UBCecohydro/Ecohydro.Arduino/mega-shield/ecohydro-mega-shield-pcb.png

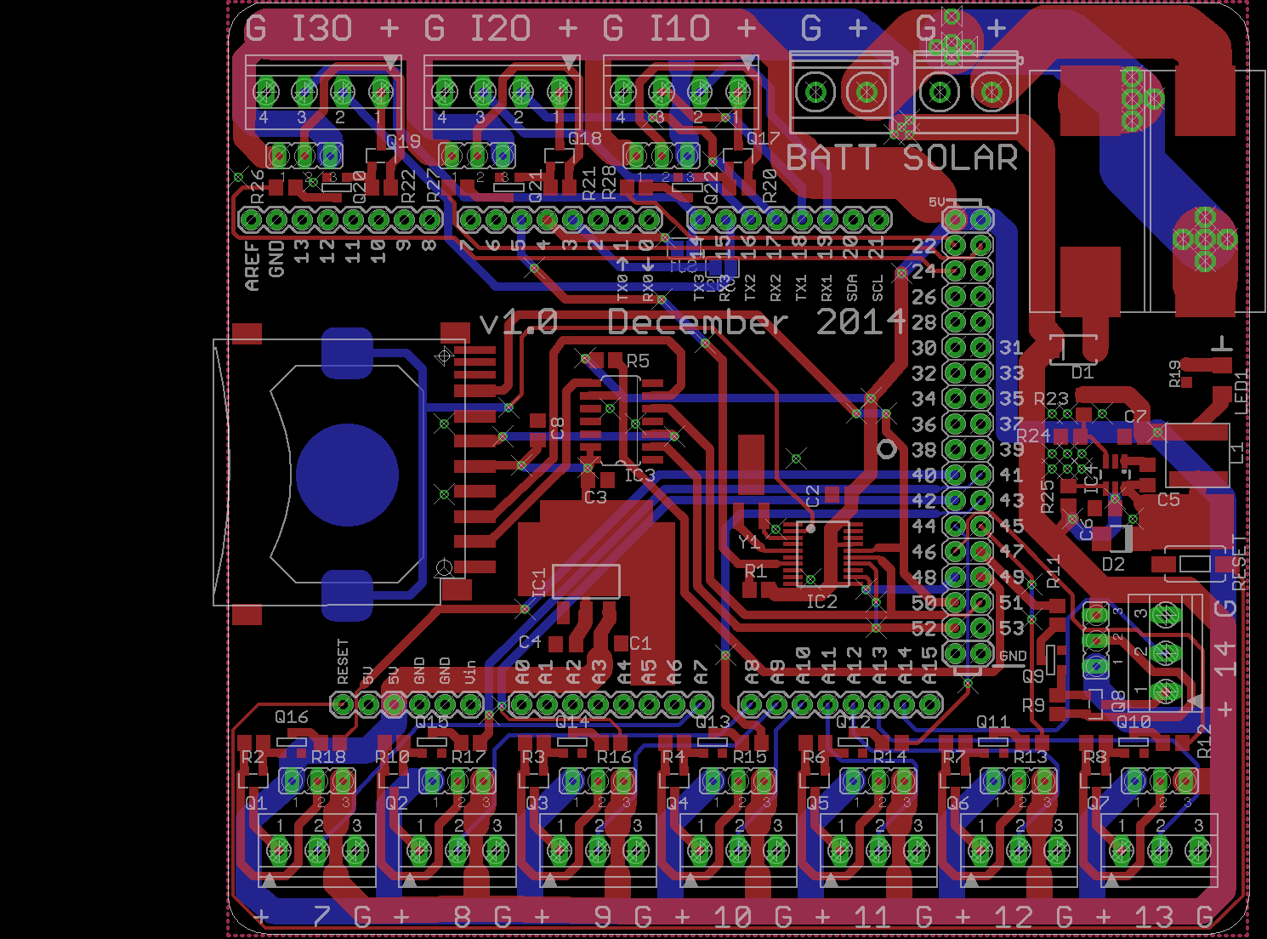
mega-shield/ecohydro-mega-shield-pcb.png
