UBCecohydro/Ecohydro.Arduino/mega-shield/ecohydro-mega-shield-schematic.png

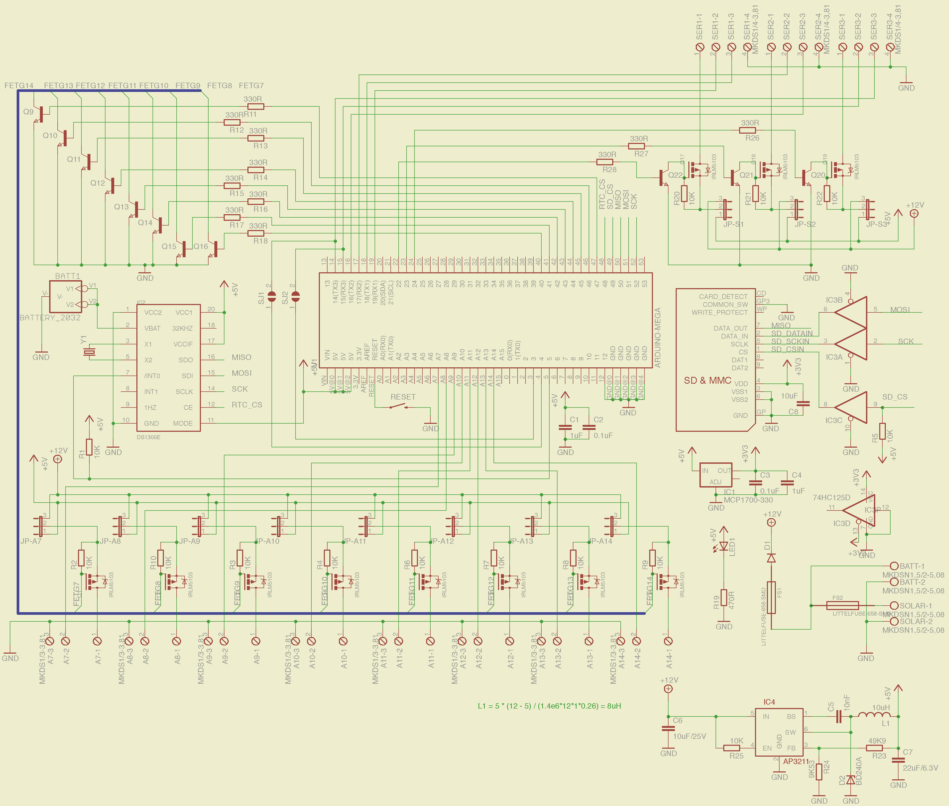
mega-shield/ecohydro-mega-shield-schematic.png
