UBCecohydro/Ecohydro.Arduino/mega-shield/ecohydro-mega-shield.xlsx

Qty | Value | Device | Package | Parts | Description | DIGIKEY | MOUSER | PROD_ID
1 |  | CRYSTAL32-SMD | CRYSTAL-32KHZ-SMD | Y1 | Various standard crystals. Proven footprints. Spark Fun Electronics SKU : COM-00534 | 535-12051-1-ND |  | XTAL-07894
1 |  | DIODESMA | SMA-DIODE | D1 | Diode | S1GFSCT-ND | 625-RS1A-E3/5AT
11 |  | JP2E | JP2 | JP-A7, JP-A8, JP-A9, JP-A10, JP-A11, JP-A12, JP-A13, JP-A14, JP-S1, JP-S2, JP-S3 | JUMPER
1 |  | LED1206 | LED-1206 | LED1 | Light Emitting Diode
2 |  | SJ | SJ | SJ1, SJ2 | SMD solder JUMPER
2 | 0.1uF | C-EUC0805K | C0805K | C2, C3 | CAPACITOR, European symbol
14 | 10K | R-EU_M0805 | M0805 | R1, R2, R3, R4, R5, R6, R7, R8, R9, R10, R20, R21, R22, R25 | RESISTOR, European symbol
1 | 10nF | C-EUC0805K | C0805K | C5 | CAPACITOR, European symbol | 490-1664-1-ND
1 | 10uF | C-EUC0805K | C0805K | C8 | CAPACITOR, European symbol
1 | 10uF/25V | C-EUC0805K | C0805K | C6 | CAPACITOR, European symbol | 1276-2891-1-ND
1 | 10uH | L-USSRN6028N | L6028 | L1 | INDUCTOR, American symbol | 732-5536-1-ND
2 | 1uF | C-EUC0805K | C0805K | C1, C4 | CAPACITOR, European symbol
1 | 22uF/10V | C-EUC0805K | C0805K | C7 | CAPACITOR, European symbol | 1276-1100-1-ND
8 | 330R | R-EU_M0805 | M0805 | R11, R12, R13, R14, R15, R16, R17, R18 | RESISTOR, European symbol | 541-330ACT-ND
3 | 330R | R-EU_M0805 | M0805 | R26, R27, R28 | RESISTOR, European symbol
1 | 4K7 | R-EU_M0805 | M0805 | R19 | RESISTOR, European symbol
1 | 49K9 | R-EU_M0805 | M0805 | R23 | RESISTOR, European symbol | 541-49.9KCCT-ND
1 | 74HC125D | 74HC125D | SO14 | IC3 | Quad bus BUFFER, 3-state | 568-1392-2-ND
1 | 9K53 | R-EU_M0805 | M0805 | R24 | RESISTOR, European symbol | 541-9.53KCCT-ND
1 | AP3211KTR | AP3211KTR | SOT23-6 | IC4 |  | AP3211KTR-G1DICT-ND | 621-AP3211KTR-G1
1 | ARDUINO-MEGA | ARDUINO-MEGA | ARDUINO_MEGA_NOHOLES | U1 | Arduino Mega board footprint
1 | BATTERY_2032 | BATTERY_2032 | BATT2032 | BATT1 | BATTERY | BK-883CT-ND
1 | BD240A | ZENER-DIODE-DO214AC | DO-214AC | D2 | Z-Diode | B240A-E3/61TGICT-ND | 625-B240A-E3/61T
1 | DS1306E | DS1306E | SSOP20 | IC2 | Serial Alarm Real-Time Clock | DS1306EN+T&RCT-ND
11 | IRLM5103 | IRLM5103 | MICRO3 | Q1, Q2, Q3, Q4, Q5, Q6, Q7, Q8, Q17, Q18, Q19 | HEXFET P-Channel Power MOSFET | IRLML5103PBFCT-ND | 942-IRLML5103TRPBF
2 | LITTELFUSE-658-SMD | LITTELFUSE-658-SMD | LITTELFUSE-658-SMD | FS1, FS2 |  | 486-1260-ND | 576-65800001109
1 | MCP1700-330 | V_REG_LM1117SOT223 | SOT223 | IC1 | Voltage Regulator LM1117 | AP1117IE33G-13DITR-ND
8 | MKDS1/3-3,81 | MKDS1/3-3,81 | 3POL381 | A7, A8, A9, A10, A11, A12, A13, A14 | MKDS 1/3-3,81 - Order No. 1727023 (RS-Online - 101-5390)
3 | MKDS1/4-3,81 | MKDS1/4-3,81 | 4POL381 | SER1, SER2, SER3 | MKDS 1/4-3,81 - Order No. 1727036
2 | MKDSN1,5/2-5,08 | MKDSN1,5/2-5,08 | MKDSN1,5/2-5,08 | BATT, SOLAR | MKDSN 1,5/ 2-5,08 Printklemme
11 | PBSS4021NT,215 | PBSS4021NT,215 | SOT-23 | Q9, Q10, Q11, Q12, Q13, Q14, Q15, Q16, Q20, Q21, Q22 |  | PBSS4021NT,215
1 | SDMMC06132 | SDMMC06132 | 6132 | U$1 | SD MMC Card holder
1 | SWITCH-MOMENTARY-2-SMD-1101NE | SWITCH-MOMENTARY-2-SMD-1101NE | TACTILE-SWITCH-1101NE | RESET | Various NO switches- pushbuttons, reed, etc
 |  |  |  |  | 1A Fuse | 507-1261-ND
 |  |  |  |  | 4A Fuse | 507-1268-ND
