UBCecohydro/Ecohydro.Arduino/mega-shield/ecohydro-mega-shield.brd

## EAGLE design mega-shield/ecohydro-mega-shield.brd (2016-04-15)

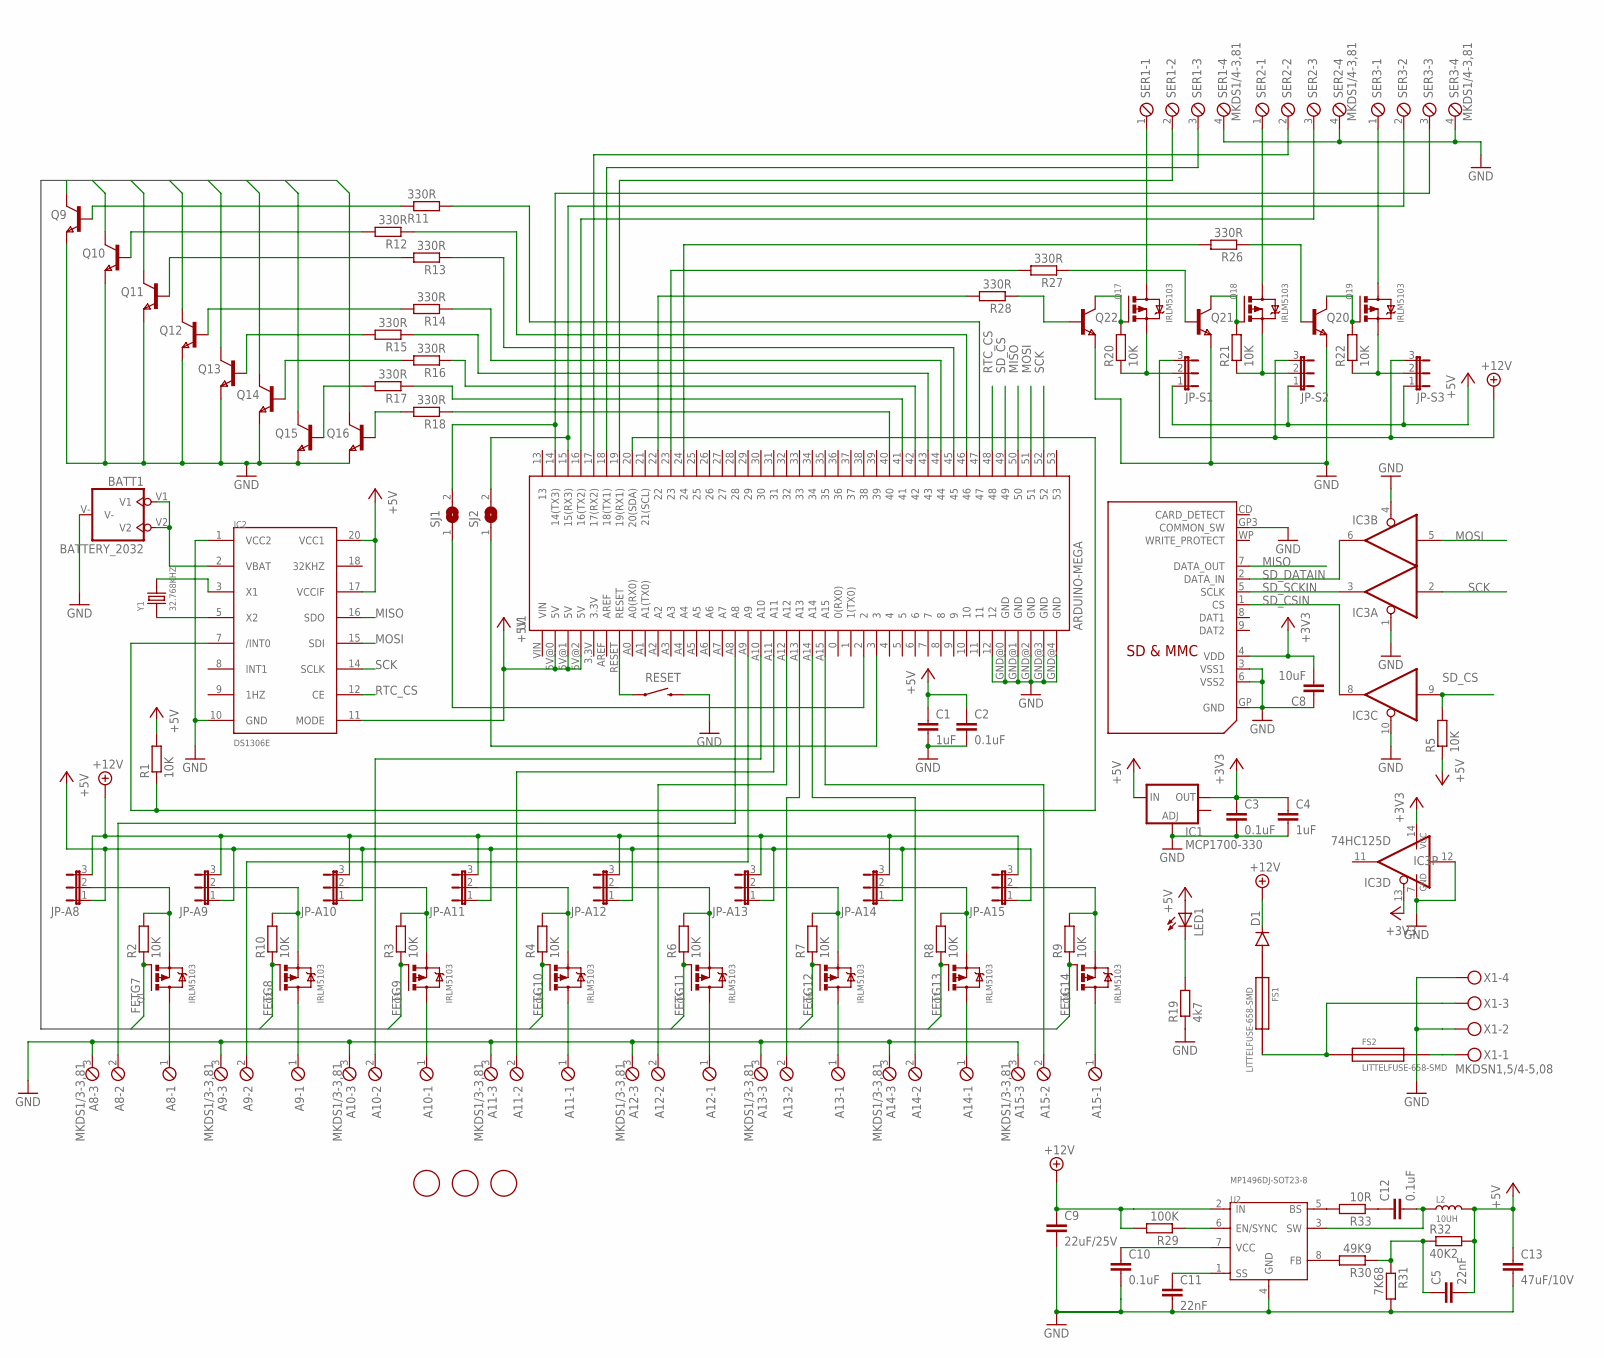
[picture p3: schematic ecohydro-mega-shield.sch]

Parts:
A8, A9, A10, A11, A12, A13, A14, A15: MKDS1/3-3,81; 3POL381
BATT1: BATTERY_2032; BATT2032; DIGIKEY BK-883CT-ND
C1, C4: 1uF; C0805K
C2, C3, C10, C12: 0.1uF; C0805K
C5, C11: 22nF; C0805K
C8: 10uF; C0805K
C9: 22uF/25V; C0805K; DIGIKEY 1276-2891-1-ND
C13: 47uF/10V; C0805K; DIGIKEY 709-1231-1-ND
D1: DIODESMA; SMA-DIODE; DIGIKEY S1GFSCT-ND
FS1, FS2: LITTELFUSE-658-SMD; MOUSER 576-65800001109
IC1: MCP1700-330; SOT223; DIGIKEY AP1117IE33G-13DITR-ND
IC2: DS1306E; SSOP20; DIGIKEY DS1306EN+T&RCT-ND
IC3: 74HC125D; SO14; DIGIKEY 568-1392-2-ND
JP-A8, JP-A9, JP-A10, JP-A11, JP-A12, JP-A13, JP-A14, JP-A15: JP2E; JP2
JP-S1, JP-S2, JP-S3: JP2E; JP2
L2: 10UH; SMD-2P-L6.0XW6.0XH3.0MM; DIGIKEY 732-5536-1-ND
LED1: LED1206; LED-1206
Q1, Q2, Q3, Q4, Q5, Q6, Q7, Q8, Q17, Q18, Q19: IRLM5103; MICRO3
Q9, Q10, Q11, Q12, Q13, Q14, Q15, Q16, Q20, Q21, Q22: PBSS4021NT,215; SOT23; DIGIKEY PBSS4021NT,215
R1, R2, R3, R4, R5, R6, R7, R8, R9, R10, R20, R21, R22: 10K; M0805
R11, R12, R13, R14, R15, R16, R17, R18: 330R; M0805; DIGIKEY 541-330ACT-ND
R19: 4k7; R0805
R26, R27, R28: 330R; M0805
R29: 100K; M0805
R30: 49K9; M0805; DIGIKEY 541-49.9KCCT-ND
R31: 7K68; M0805; DIGIKEY 541-49.9KCCT-ND
R32: 40K2; M0805; DIGIKEY 541-49.9KCCT-ND
R33: 10R; M0805; DIGIKEY 541-49.9KCCT-ND
RESET: SWITCH-MOMENTARY-2-SMD-1101NE; TACTILE-SWITCH-1101NE
SER1, SER2, SER3: MKDS1/4-3,81; 4POL381
SJ1, SJ2: SJ
U1: ARDUINO-MEGA; ARDUINO_MEGA_NOHOLES
U2: MP1496DJ-SOT23-8; SOT-23-8
U$1: SDMMC06132; 06132
U$2, U$3, U$4: FIDUCIAL; FIDUCIAL_1MM
X1: MKDSN1,5/4-5,08
Y1: 32.768KHZ; X2-SMD-L2.0X1.2X0.55MM; DIGIKEY 535-12051-1-ND

Connections:
+3V3: C3.1, C4.1, C8.2, IC1.2 (OUT), IC3.13 (OE), IC3.14 (VCC), U$1.4 (VDD)
+5V: C1.1, C2.1, C5.2, C13.1, IC1.3 (IN), IC2.11 (MODE), IC2.17 (VCCIF), IC2.20 (VCC1), JP-A8.1, JP-A9.1, JP-A10.1, JP-A11.1, JP-A12.1, JP-A13.1, JP-A14.1, JP-A15.1, JP-S1.1, JP-S2.1, JP-S3.1, L2.2, LED1.A, R1.2, R5.1, R32.2, U1.5V@0 (5V), U1.5V@1 (5V), U1.5V@2 (5V)
+12V: C9.1, D1.C, JP-A8.3, JP-A9.3, JP-A10.3, JP-A11.3, JP-A12.3, JP-A13.3, JP-A14.3, JP-A15.3, JP-S1.3, JP-S2.3, JP-S3.3, R29.2, U2.2 (IN)
+12VRAW: D1.A, FS1.1
FETG7: Q1.1 (G), Q16.3 (C), R2.1
FETG8: Q2.1 (G), Q15.3 (C), R10.1
FETG9: Q3.1 (G), Q14.3 (C), R3.1
FETG10: Q4.1 (G), Q13.3 (C), R4.1
FETG11: Q5.1 (G), Q12.3 (C), R6.1
FETG12: Q6.1 (G), Q11.3 (C), R7.1
FETG13: Q7.1 (G), Q10.3 (C), R8.1
FETG14: Q8.1 (G), Q9.3 (C), R9.1
GND: A8.3, A9.3, A10.3, A11.3, A12.3, A13.3, A14.3, A15.3, BATT1.V-, C1.2, C2.2, C3.2, C4.2, C8.1, C9.2, C10.2, C11.2, C13.2, IC1.1 (ADJ), IC2.1 (VCC2), IC2.10 (GND), IC3.1 (OE), IC3.4 (OE), IC3.7 (GND), IC3.10 (OE), IC3.12 (I), Q9.2 (E), Q10.2 (E), Q11.2 (E), Q12.2 (E), Q13.2 (E), Q14.2 (E), Q15.2 (E), Q16.2 (E), Q20.2 (E), Q21.2 (E), Q22.2 (E), R19.1, R31.2, RESET.P$2 (2), SER1.4, SER2.4, SER3.4, U1.12, U1.GND@0 (GND), U1.GND@1 (GND), U1.GND@2 (GND), U1.GND@3 (GND), U1.GND@4 (GND), U2.4 (GND), U$1.3 (VSS1), U$1.6 (VSS2), U$1.GP (GND), U$1.GP3 (COMMON_SW), X1.2, X1.4
MISO: IC2.16 (SDO), U1.50, U$1.7 (DATA_OUT)
MOSI: IC2.15 (SDI), IC3.5 (I), U1.51
unnamed: IC2.5 (X2), Y1.1
unnamed: RESET.P$1 (1), U1.RESET
unnamed: IC2.3 (X1), Y1.2
unnamed: A8.1, Q1.3 (D)
unnamed: A8.2, U1.A8
unnamed: A9.1, Q2.3 (D)
unnamed: A9.2, U1.A9
unnamed: A10.1, Q3.3 (D)
unnamed: A15.1, Q8.3 (D)
unnamed: A14.1, Q7.3 (D)
unnamed: A13.1, Q6.3 (D)
unnamed: A12.1, Q5.3 (D)
unnamed: A11.1, Q4.3 (D)
unnamed: IC2.7 (/INT0), R1.1, U1.20 (20(SDA))
unnamed: BATT1.V1, BATT1.V2, IC2.2 (VBAT)
unnamed: JP-A8.2, Q1.2 (S), R2.2
unnamed: A10.2, U1.A10
unnamed: A11.2, U1.A11
unnamed: JP-A10.2, Q3.2 (S), R3.2
unnamed: A12.2, U1.A12
unnamed: JP-A15.2, Q8.2 (S), R9.2
unnamed: JP-A14.2, Q7.2 (S), R8.2
unnamed: JP-A13.2, Q6.2 (S), R7.2
unnamed: JP-A12.2, Q5.2 (S), R6.2
unnamed: JP-A11.2, Q4.2 (S), R4.2
unnamed: JP-A9.2, Q2.2 (S), R10.2
unnamed: Q11.1 (B), R13.2
unnamed: Q12.1 (B), R14.2
unnamed: Q13.1 (B), R15.2
unnamed: A13.2, U1.A13
unnamed: Q14.1 (B), R16.2
unnamed: Q15.1 (B), R17.2
unnamed: Q16.1 (B), R18.2
unnamed: Q9.1 (B), R11.1
unnamed: Q10.1 (B), R12.2
unnamed: R11.2, U1.47
unnamed: R12.1, U1.46
unnamed: R13.1, U1.45
unnamed: R14.1, U1.44
unnamed: R15.1, U1.43
unnamed: R16.1, U1.42
unnamed: R17.1, U1.41
unnamed: R18.1, U1.40
unnamed: FS1.2, FS2.1, X1.3
unnamed: FS2.2, X1.1
unnamed: SER1.3, U1.18 (18(TX1))
unnamed: SER1.2, U1.19 (19(RX1))
unnamed: SER2.2, U1.17 (17(RX2))
unnamed: SER2.3, U1.16 (16(TX2))
unnamed: SER3.2, SJ2.2, U1.15 (15(RX3))
unnamed: SER3.3, SJ1.2, U1.14 (14(TX3))
unnamed: LED1.C, R19.2
unnamed: Q17.3 (D), SER1.1
unnamed: Q18.3 (D), SER2.1
unnamed: Q19.3 (D), SER3.1
unnamed: Q17.1 (G), Q22.3 (C), R20.2
unnamed: Q18.1 (G), Q21.3 (C), R21.2
unnamed: Q19.1 (G), Q20.3 (C), R22.2
unnamed: JP-S1.2, Q17.2 (S), R20.1
unnamed: JP-S2.2, Q18.2 (S), R21.1
unnamed: JP-S3.2, Q19.2 (S), R22.1
unnamed: Q20.1 (B), R26.1
unnamed: R26.2, U1.24
unnamed: Q21.1 (B), R27.1
unnamed: R27.2, U1.23
unnamed: Q22.1 (B), R28.1
unnamed: R28.2, U1.22
unnamed: C10.1, U2.7 (VCC)
unnamed: SJ2.1, U1.3
unnamed: R29.1, U2.6 (EN/SYNC)
unnamed: C11.1, U2.1 (SS)
unnamed: SJ1.1, U1.2
unnamed: R30.2, U2.8 (FB)
unnamed: C5.1, R30.1, R31.1, R32.1
unnamed: C12.2, L2.1, U2.3 (SW)
unnamed: R33.2, U2.5 (BS)
unnamed: C12.1, R33.1
unnamed: A14.2, U1.A14
unnamed: A15.2, U1.A15
RTC_CS: IC2.12 (CE), U1.48
SCK: IC2.14 (SCLK), IC3.2 (I), U1.52
SD_CS: IC3.9 (I), R5.2, U1.49
SD_CSIN: IC3.8 (O), U$1.1 (CS)
SD_DATAIN: IC3.6 (O), U$1.2 (DATA_IN)
SD_SCKIN: IC3.3 (O), U$1.5 (SCLK)

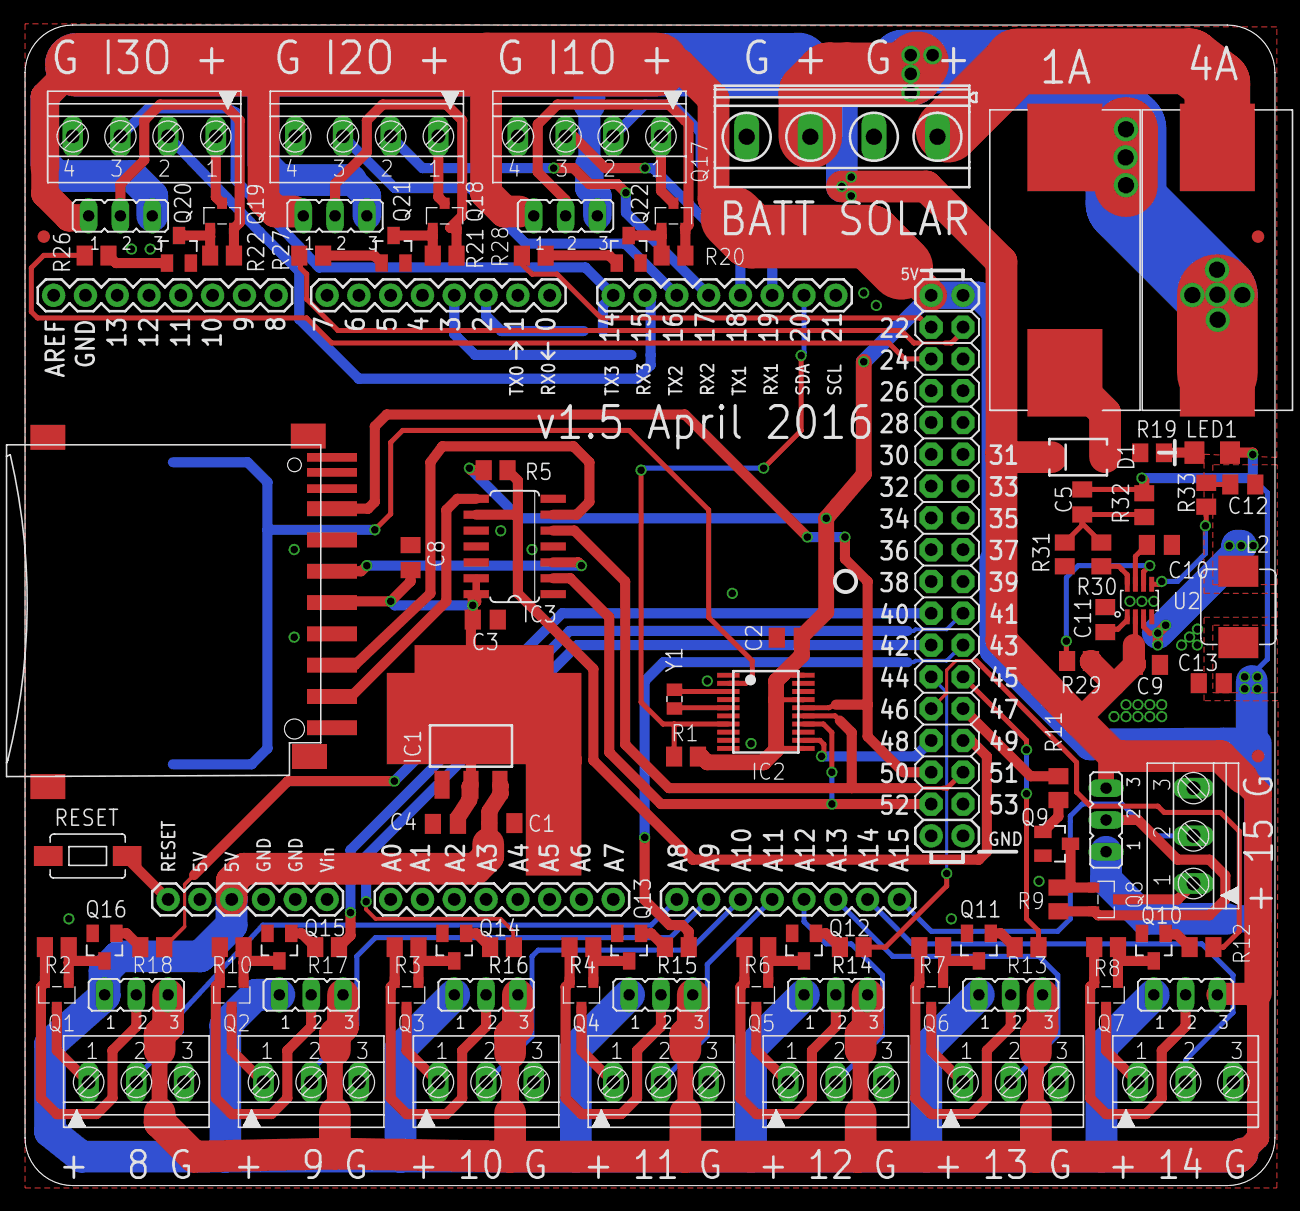
[picture p4: board ecohydro-mega-shield.brd from above]

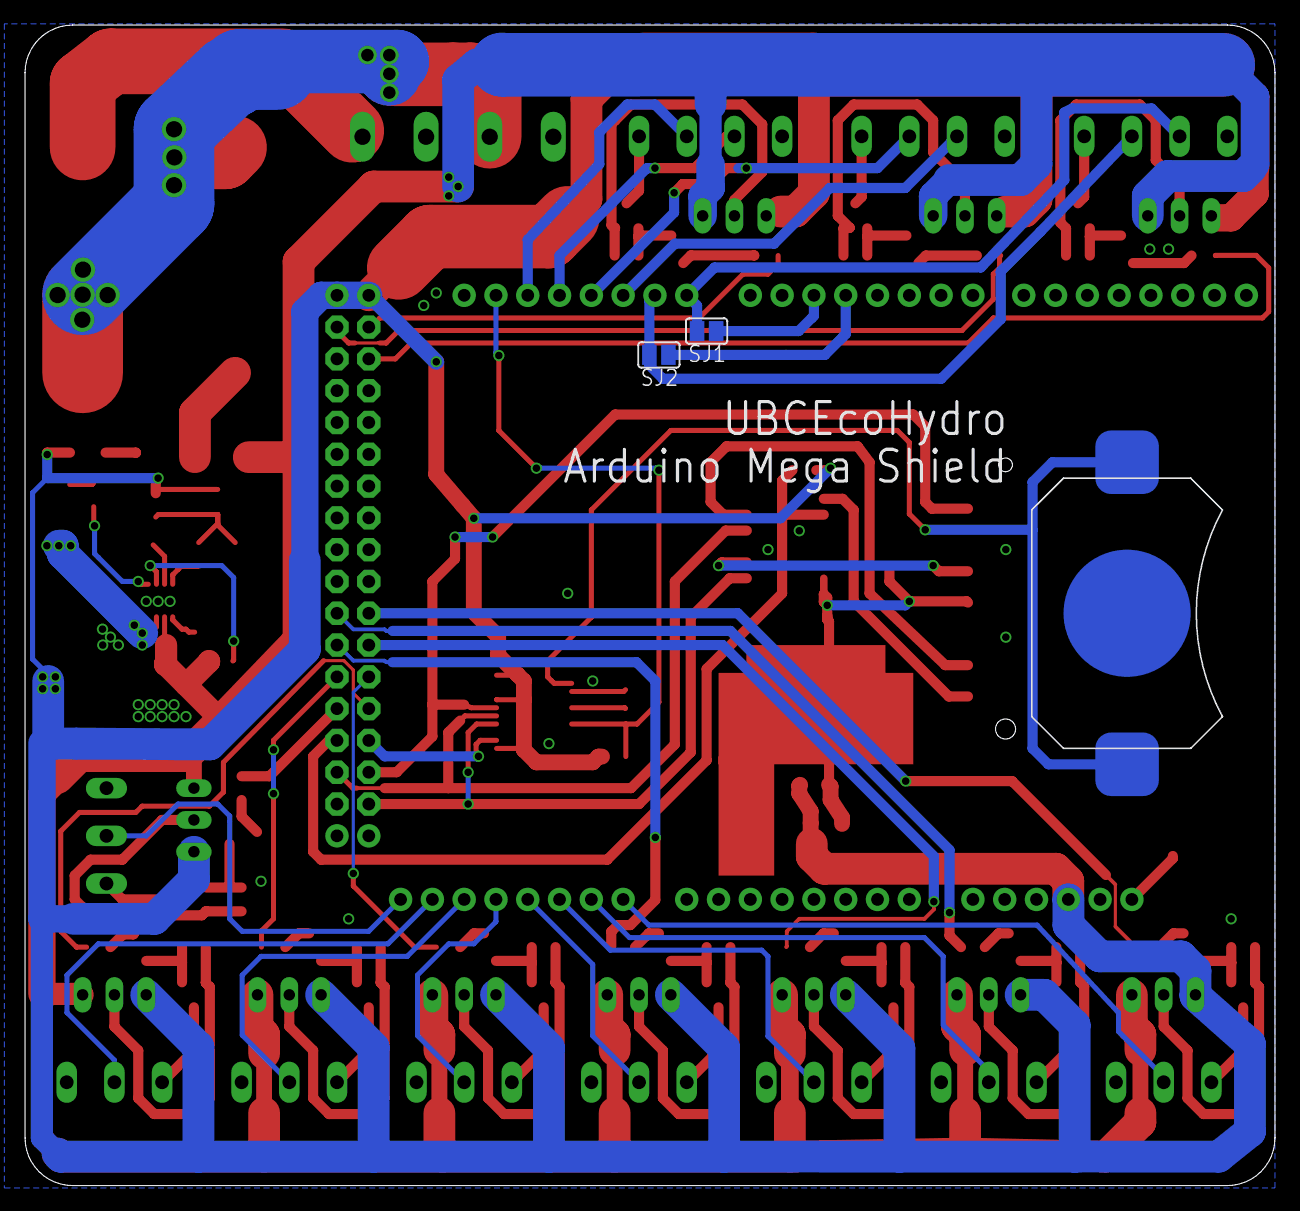
[picture p5: board ecohydro-mega-shield.brd from below]

Board: 2 copper layers, 99.8 x 92.7 mm, 105 parts (3 on the bottom side), 100 nets.
