UBCecohydro/Ecohydro.Arduino/(commit log)

2016-02-27 Updated version with release notes
    [ecohydro-mega-shield.brd, ecohydro-mega-shield.sch]
2016-02-29 Add schematic image
2016-02-29 Cleaned up pcb image
2016-03-01 Added files via upload
    Arduino Protocol for programming Ecohydro Logger to query SDI-sensor data and record it on SD card
2016-03-01 Added files via upload
    Arduino protocol for setting time on Ecohydro Logger
2016-04-05 Added gerbers for rev 1.0
2016-04-06 Rev 1.1 with some fixes, not sent for production yet
    [ecohydro-mega-shield.brd, ecohydro-mega-shield.sch]
2016-04-06 Rev 1.2 Fixes - Change R19 to 4k7 - GSM shield bypass pins are out by 1 (should be 2 & 3, not 3 & 4) - Change pads on Batt and Solar connectors - Change package on xtal
    [ecohydro-mega-shield.brd, ecohydro-mega-shield.sch]
2016-04-06 Add BoM
    [ecohydro-mega-shield.xlsx]
2016-04-06 Updated C7 voltage
    [ecohydro-mega-shield.xlsx]
2016-04-08 Rev 1.4 - Reduced board size by 2mm to fit 10x10 economy pcb mfg
    [ecohydro-mega-shield.brd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]
2016-04-10 Rev 1.5 - Add fiducials
    [ecohydro-mega-shield.brd, ecohydro-mega-shield.sch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]
2016-04-15 Fix designators on power select jumpers
    [ecohydro-mega-shield.brd, ecohydro-mega-shield.sch]
